darshanpvt007-afk/visionguard-smart-cane/docs/VisionGuard_Presentation.pptx

## VisionGuard

COURSE PROJECT

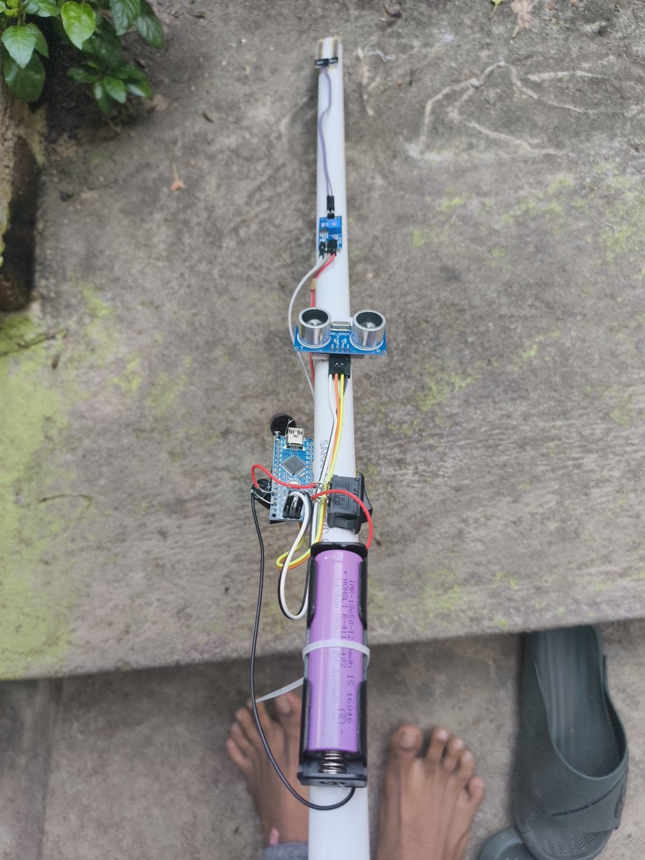
[picture p7: figure]

Smart cane for visually impaired people: obstacle and wet-surface warning with an Arduino Nano

S Darshan (25BCE2883) · Tanay Agarwal (25BCE2475)
BACSE324 Embedded Systems Architecture | B.Tech CSE, VIT Vellore

Notes: SPEAKER: BOTH (~25 s)

ACTION: Stand on either side of the screen. Darshan holds the cane.

DARSHAN: Good morning, sir. I'm S Darshan, registration number 25BCE2883.

TANAY: And I'm Tanay Agarwal, 25BCE2475.

DARSHAN: Our project is VisionGuard, a smart cane for visually impaired people. It warns the user about obstacles in front of them and about water at the tip of the cane.

## What this presentation covers

Problem

Why a normal cane is not enough

Objectives

What the cane must achieve

System design

Block diagram, hardware, circuit

01

02

03

Software

Algorithm, DFG, state diagram, code

Results

Prototype, tests and cost

Way forward

Limitations and future scope

04

05

06

Notes: SPEAKER: DARSHAN (~20 s)

DARSHAN: First I'll explain the problem, our objectives, the system design and the sensors. Then Tanay will cover the power, circuit, software, results, cost and future scope.

## The problem with a white cane

2.2 billion

people worldwide live with a near or distance vision impairment

Source: WHO, World Report on Vision, 2019

Contact-only detection

Obstacles are found only when the cane hits them, about 1 m ahead

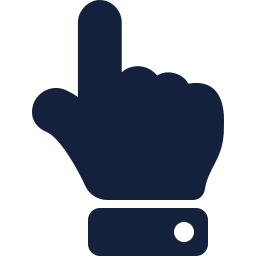
[picture p8: figure]
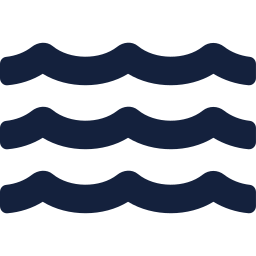
[picture p9: figure]

No water warning

Puddles, open drains and wet mud go unnoticed until stepped in

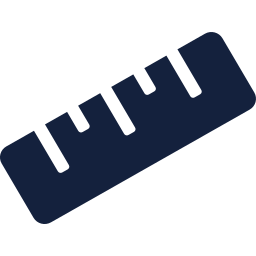
[picture p10: figure]

No distance information

The user cannot tell how close an obstacle is

Notes: SPEAKER: DARSHAN (~40 s)

ACTION: Point at the 2.2 billion figure, then the three points.

DARSHAN: According to the WHO, about 2.2 billion people around the world have some kind of vision impairment. Most blind people use a white cane, but it has three problems. First, it finds an obstacle only when it actually hits it. Second, it can't warn about water, puddles or open drains. Third, it doesn't tell the user how far away the obstacle is.

## Existing solutions and their limits

White cane

+ Cheap and simple

− Contact-only, no water or distance warning

Guide dog

+ Excellent navigation

− Expensive, long training, not widely available

Commercial canes

+ Electronic early warning

− High cost, imported, hard to repair locally

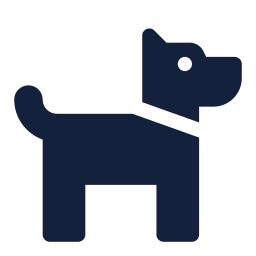
[picture p11: figure]
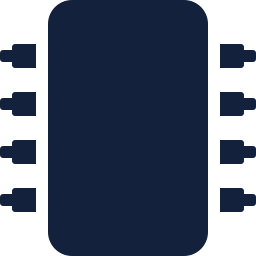
[picture p12: figure]

The gap: a low-cost cane that warns early about obstacles and about water underfoot

Notes: SPEAKER: DARSHAN (~35 s)

ACTION: Move left to right across the three boxes.

DARSHAN: We looked at what already exists. A white cane is cheap and simple, but it works only on contact. A guide dog is very helpful, but it's expensive, needs long training and isn't easily available. There are commercial smart canes, but they're costly, mostly imported and hard to repair here. So the gap we saw is a low-cost cane that warns early about both obstacles and water.

## Objectives

50 cm

Detect obstacles ahead with an ultrasonic sensor and warn before contact

50–400 ms

Encode distance in the beep gap: closer obstacle, faster beeps

< 500

ADC reading below this means water: continuous tone, top priority

₹876

Low-cost, portable cane running on one 18650 cell with a switch

Notes: SPEAKER: DARSHAN (~40 s)

ACTION: Point at each number as you say it.

DARSHAN: We set four objectives. One: detect obstacles within 50 centimetres. Two: show the distance through the beep speed. The gap between beeps goes from 50 milliseconds when the obstacle is very close to 400 milliseconds at 50 centimetres. Three: detect water when the moisture reading drops below 500 out of 1023, and give that the highest priority. Four: keep it cheap and portable. The cane parts cost about 876 rupees, and it runs on one battery.

## Proposed solution: VisionGuard

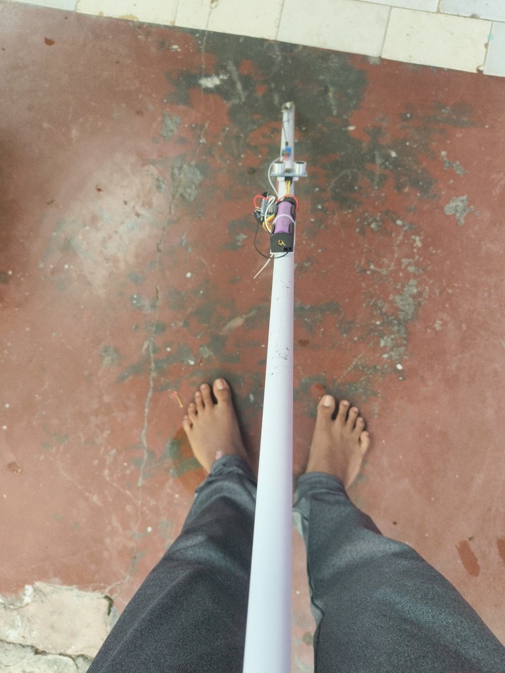
[picture p13: figure]

Ultrasonic “eyes”

HC-SR04 measures distance to obstacles ahead

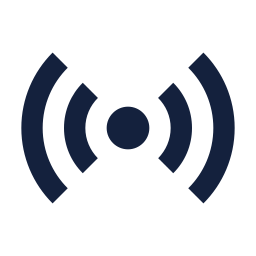
[picture p14: figure]
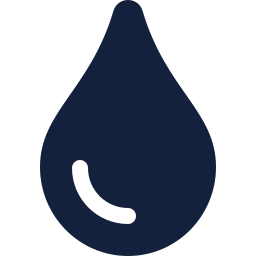
[picture p15: figure]

Moisture-sensing tip

Probe at the bottom detects water and wet mud

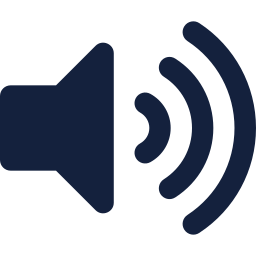
[picture p16: figure]

Prioritised buzzer alerts

Continuous tone for water; faster beeps as obstacles get closer

Notes: SPEAKER: DARSHAN (~35 s)

ACTION: Hold up the cane next to the photo.

DARSHAN: Our solution has three main parts on a PVC pipe: an ultrasonic sensor that works like the cane's eyes, a moisture probe at the tip, and a buzzer that gives alerts by priority. The idea actually started as a smart shoe. We moved it to a cane because the cane tip reaches water before the foot does, and a sensor on the shaft stays steadier than one on a moving shoe.

## Block diagram

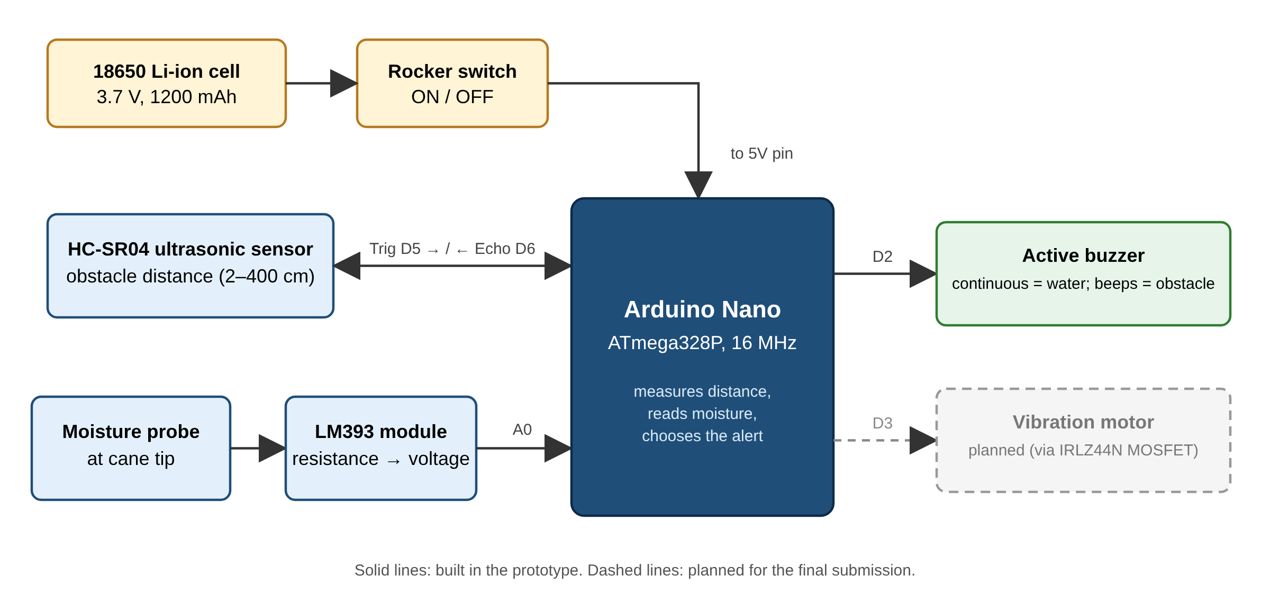
[picture p17: figure]

Notes: SPEAKER: DARSHAN (~40 s)

ACTION: Trace the diagram left, middle, right, then top.

DARSHAN: This is our block diagram. On the left are the inputs: the ultrasonic sensor connected to pins D5 and D6, and the moisture probe connected through the LM393 module to pin A0. In the middle is the Arduino Nano, which makes all the decisions. On the right is the output, the buzzer on pin D2. At the top, the battery powers everything through the on/off switch. The dashed box is a vibration motor, which we plan to add later.

## Hardware components

Arduino Nano

ATmega328P controller

HC-SR04

Ultrasonic distance sensor

Moisture probe

Water sensing at the tip

LM393 module

Probe resistance → voltage

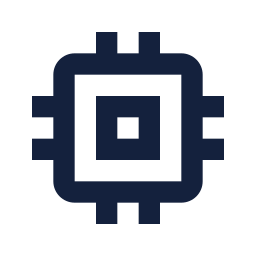
[picture p18: figure]
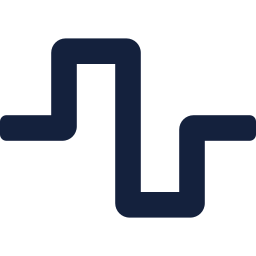
[picture p19: figure]

Active buzzer

Audio alert on D2

18650 Li-ion

3.7 V, 1200 mAh

Rocker switch

Power ON / OFF

Capacitor

220 µF, 50 V supply filter

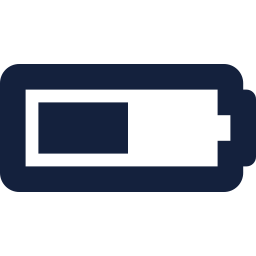
[picture p20: figure]
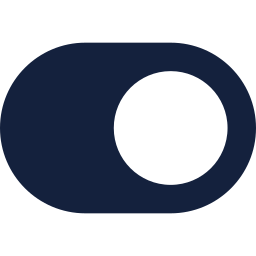
[picture p21: figure]
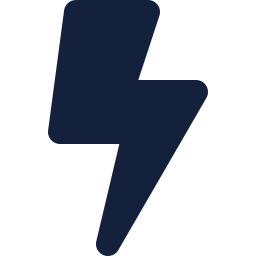
[picture p22: figure]

Notes: SPEAKER: DARSHAN (~35 s)

ACTION: Go across the top row, then the bottom row.

DARSHAN: These are the eight parts we used. The Arduino Nano is the controller. The HC-SR04 measures distance. The moisture probe and the LM393 module detect water. The active buzzer gives the alerts. The 18650 battery, the rocker switch and a 220 microfarad capacitor make up the power side. The capacitor smooths the supply so the Nano doesn't reset when the buzzer switches on.

## Why the Arduino Nano

16 MHz

ATmega328P clock

32 KB

Flash memory

- Small and light enough to mount on the cane shaft
- Low cost (about ₹250) and easy to replace
- 5 V logic matches the HC-SR04 and the moisture module
- Built-in ADC reads the moisture voltage directly
- Programmed over USB with the free Arduino IDE

10-bit

ADC, 8 analog inputs

18×45 mm

Fits on a cane

Notes: SPEAKER: DARSHAN (~30 s)

DARSHAN: We chose the Arduino Nano because it's small, only 18 by 45 millimetres, so it fits on a cane. It costs about 250 rupees. It uses 5-volt logic like our sensors, and it has a built-in 10-bit ADC to read the moisture sensor. It's also easy to program over USB. A Raspberry Pi would be too expensive and power-hungry for a simple job like this.

## How the ultrasonic sensor measures distance

1

Trigger

Nano holds Trig HIGH for 10 µs

d = v × t / 2

v ≈ 343 m/s = 0.034 cm/µs
÷ 2 because sound travels there and back
Example: t = 1000 µs → d = 0.034 × 1000 / 2 = 17 cm
Range 2–400 cm · beam ≈ 15°

2

Burst

Sensor sends eight 40 kHz sound pulses

3

Echo

Echo stays HIGH for the round-trip time t

Notes: SPEAKER: DARSHAN (~45 s)

ACTION: Point at steps 1, 2, 3, then the formula box.

DARSHAN: This is how the ultrasonic sensor works. Step one: the Nano sends a 10-microsecond pulse to the Trig pin. Step two: the sensor sends out eight sound pulses at 40 kilohertz, which is too high for us to hear. Step three: the Echo pin stays HIGH until the echo comes back. So distance equals speed of sound times time, divided by two. We divide by two because the sound goes to the object and comes back. The speed of sound is about 0.034 centimetres per microsecond, so if the echo takes 1000 microseconds, the distance is 17 centimetres.

## How the tip detects water

Water conducts electricity, so the resistance Rp between the copper tracks drops. The LM393 module turns this into a voltage:

V_A0 = Vcc × Rp / (Rp + Rf)

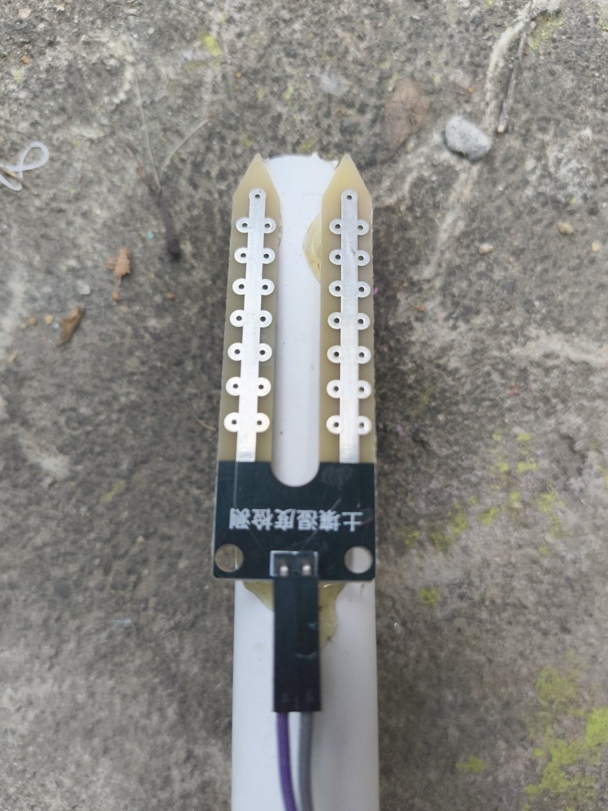
[picture p23: figure]

Moisture probe at the cane tip: two exposed copper tracks

≈ 1023

Dry: Rp very high

< 500

Wet: water alert

The reading is ratiometric (independent of battery voltage). The D0 output is unused; the threshold is set in code.

Notes: SPEAKER: DARSHAN (~45 s)

ACTION: Point at the probe on the real cane. End by turning towards Tanay.

DARSHAN: This is the moisture probe at the tip. It has two copper strips. Dry air doesn't conduct electricity, but water does, so when the tip touches water, the resistance between the strips drops. The LM393 module turns this into a voltage, and the Nano reads it on A0. When it's dry the reading is about 1023, and when it's wet it goes below 500. We use the analog output instead of the digital D0 pin, so we can set the threshold in the code.

DARSHAN: Now Tanay will explain the power system and the circuit.

## Power system

18650 cell

3.7 V, 1200 mAh

Rocker switch

ON / OFF

5V pin

Nano + both sensors

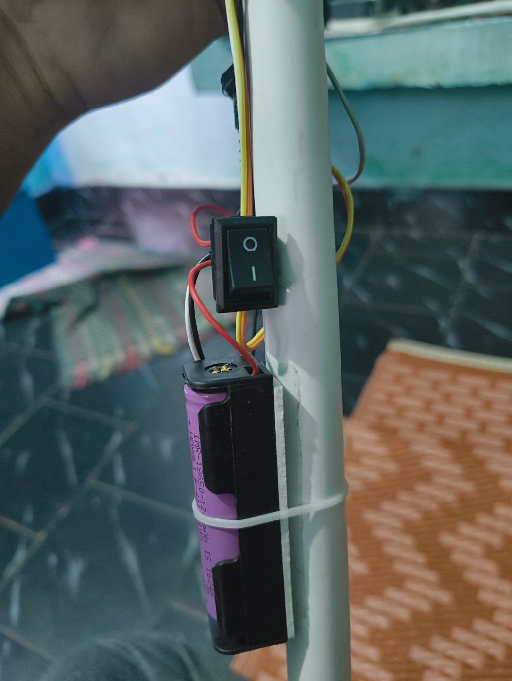
[picture p24: figure]

~40 mA

total current draw

≈ 30 h

theoretical runtime

Safety: switch OFF before plugging in USB. The battery feeds the 5V rail directly.

Notes: SPEAKER: TANAY (~35 s)

ACTION: Point at battery → switch → 5V pin, then the warning.

TANAY: Thank you. The cane runs on one 18650 lithium-ion battery: 3.7 volts, 1200 milliamp-hours. It goes through the rocker switch to the Nano's 5V pin, which also powers both sensors. We didn't use the VIN pin, because VIN needs about 7 volts. The whole cane draws around 40 milliamps, so in theory the battery can last about 30 hours. One safety point: we always switch the cane off before connecting USB, because the battery is connected directly to the 5V line.

## Circuit diagram


- Shared +5 V and GND rails
- Trig → D5, Echo → D6
- Moisture A0 → A0
- Buzzer → D2
- 220 µF capacitor across 5V and GND
- D3 reserved for a vibration motor

Notes: SPEAKER: TANAY (~40 s)

ACTION: Point at the red 5V line and black GND line first.

TANAY: This is the full circuit. The red line is 5 volts and the black line is ground. Every module shares them. Trig goes to D5, Echo to D6, the moisture signal to A0 and the buzzer to D2. In the final cane we didn't use a breadboard. We soldered male header pins onto the Nano, and since the sensors also have header pins, the signal wires are female jumper wires plugged onto both ends. The power wires, the buzzer and the 220 microfarad capacitor are soldered for a strong connection.

## Pin connections

Device pin | Nano pin | Purpose
Battery + (via switch) | 5V | Power, 3.0–4.2 V
Battery − | GND | Common ground
HC-SR04 Trig | D5 | 10 µs trigger pulse (output)
HC-SR04 Echo | D6 | Echo pulse width (input)
LM393 A0 | A0 | Moisture value 0–1023
LM393 D0 | — | Not used
Buzzer + | D2 | HIGH = sound
Sensor VCC / GND | 5V / GND | Module power

Notes: SPEAKER: TANAY (~20 s)

TANAY: This table lists every connection. The main pins to remember are D5 for Trig, D6 for Echo, A0 for moisture and D2 for the buzzer. The LM393's D0 pin isn't used.

## Algorithm

Initialise

Set pin modes, start Serial at 9600

Measure distance

Trigger, pulseIn() with 30 ms timeout, d = t × 0.034 / 2

Read moisture

m = analogRead(A0), 0–1023

1

2

3

Water?

If m < 500, buzzer ON continuously

Obstacle?

Else if 0 < d < 50, beep 50 ms, wait map(d) = 50–400 ms

Clear

Else buzzer OFF; wait 30 ms and repeat

4

5

6

Notes: SPEAKER: TANAY (~45 s)

ACTION: Point at boxes 1 to 6 in order.

TANAY: This is our algorithm. First the Nano sets up the pins. Then, in a loop, it measures the distance and reads the moisture. Then it decides. If the moisture is below 500, that's water, so the buzzer stays on continuously. If not, and an obstacle is closer than 50 centimetres, it beeps for 50 milliseconds and then waits a gap between 50 and 400 milliseconds depending on the distance. Otherwise the path is clear and the buzzer stays off. Then it waits 30 milliseconds and repeats.

## Data flow graph


Echo time t becomes distance d, which feeds two branches (near, and beep gap g); moisture m becomes wet. The priority select drives the buzzer.

Notes: SPEAKER: TANAY (~35 s)

ACTION: Trace the top path, then the bottom path, then the priority box.

TANAY: The data flow graph shows how the data is processed. The echo time t is multiplied by 0.034 and divided by 2 to get the distance d. The distance is used in two places: to check whether the obstacle is near, and to work out the beep gap g. The moisture value m is compared with 500 to decide whether it's wet. Finally, the priority block uses wet, near and g to control the buzzer.

## State diagram


Every loop the system senses, then enters exactly one state: WATER, OBSTACLE or CLEAR. Water always wins.

Notes: SPEAKER: TANAY (~30 s)

ACTION: Follow the arrows from OFF to SENSE, then the three states.

TANAY: This is the state diagram. When the switch is turned on, the cane sets up once and goes to SENSE. From SENSE it goes into exactly one state: water alert, obstacle alert or clear. After 30 milliseconds it comes back to SENSE. Turning the switch off takes it back to OFF from any state.

## Key code logic

int readDistanceCm() {
digitalWrite(TRIG_PIN, HIGH);
delayMicroseconds(10);
digitalWrite(TRIG_PIN, LOW);
unsigned long t =
pulseIn(ECHO_PIN, HIGH, 30000);
return t * 0.034 / 2;
}
if (soil < 500) // water
buzzer ON (continuous);
else if (d > 0 && d < 50)
beep, gap = map(d,2,50,50,400);
else buzzer OFF; // clear

pulseIn() timeout

30 ms, so a missed echo cannot freeze the loop

0.034 / 2

Speed of sound in cm/µs, halved for the round trip

map()

Turns 2–50 cm into a 50–400 ms beep gap

Notes: SPEAKER: TANAY (~40 s)

ACTION: Point at the top half of the code, then the bottom half. End by turning towards Darshan.

TANAY: This is the main part of our code. The readDistanceCm function sends the trigger pulse and uses pulseIn with a 30-millisecond timeout. Without the timeout, it would wait up to one second when there's no echo and freeze the cane. Below that is the if-else chain. Water is checked first, so it always has priority. The map function converts the distance into the beep gap.

TANAY: Now Darshan will show you the prototype.

## Prototype and assembly

Complete cane, tip at the top

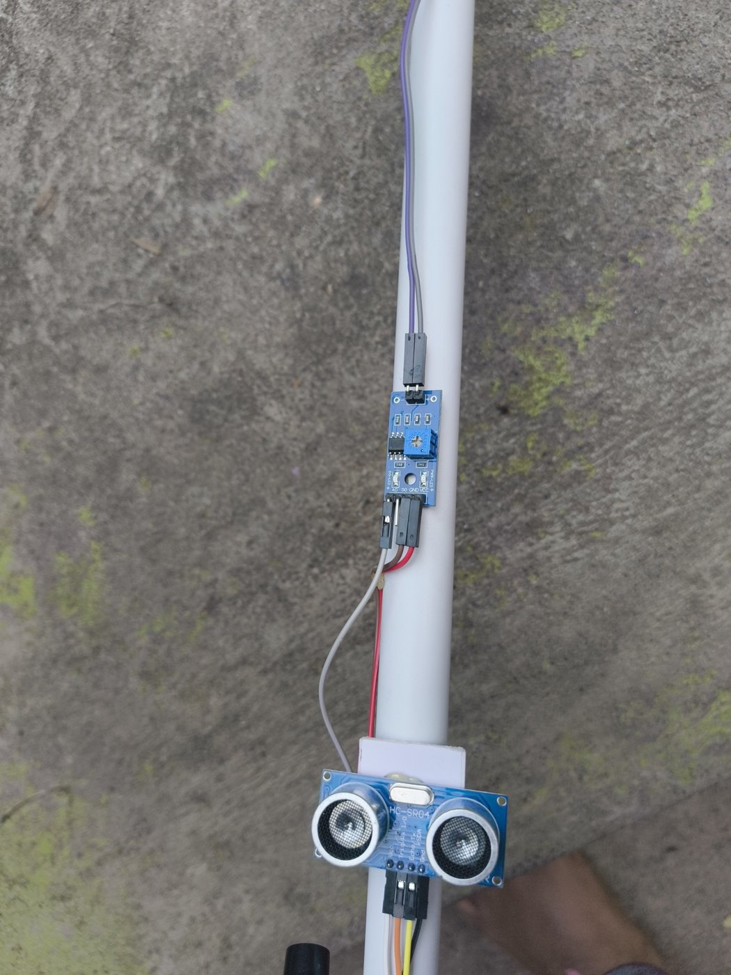
[picture p25: figure]

LM393 and HC-SR04 on female jumpers

- Male header pins soldered onto the Nano
- Sensors joined with female jumper wires: Trig D5, Echo D6, moisture A0
- Power wires, buzzer and 220 µF capacitor soldered
- Parts hot-glued to the PVC pipe; HC-SR04 on a foam spacer; battery cable-tied
- No breadboard in the final build

Notes: SPEAKER: DARSHAN (~75 s)

ACTION: Point at the photos, then at the real cane. DEMO: switch on → hand from far to near → dip tip in water.

DARSHAN: This is our prototype and how we put it together. We soldered male header pins onto the Nano and connected the sensors with female jumper wires: Trig to D5, Echo to D6 and the moisture output to A0. The power wires, the buzzer and the capacitor are soldered. All the parts are hot-glued to the PVC pipe, the ultrasonic sensor sits on a foam spacer, and the battery holder is cable-tied. From the bottom: the probe, the LM393 module, the ultrasonic sensor, the Nano with the buzzer, then the switch and battery near the handle.

DARSHAN: Let me show you. I'm switching it on. It's silent now because the path is clear. Now I'll move my hand closer. It starts beeping at 50 centimetres and gets faster as I get closer. Now I'll dip the tip in water. It gives a continuous beep, which means water is detected.

DARSHAN: Tanay will now show our test results.

## Testing and results

Test | Method | Expected | Result
Power on battery | Switch ON, no USB | Nano LED on, system runs | Verified
Obstacle alert | Move a notebook from 60 to 5 cm | Beeps under 50 cm, faster when closer | Verified
Path clear | Point at open space | Silent | To confirm
Water alert | Dip probe tip in water | Continuous tone | Calibrating
Priority | Water + obstacle together | Continuous tone (water wins) | To confirm

Update the Result column after the Serial Monitor tests (dry and wet readings).

Notes: SPEAKER: TANAY (~30 s)

ACTION: Point at the Result column.

TANAY: These are our tests. Running on battery and the obstacle alert are both verified. The water alert is in the code, and we're calibrating the exact threshold using the dry and wet readings on the Serial Monitor. We'll update this table once that's done.

## Cost of the cane hardware

₹876

total cane hardware

₹1,805 including tools (₹660) and parts for planned upgrades (₹269). Prices from the supplier invoice; buzzer and PVC body estimated.

Notes: SPEAKER: TANAY (~25 s)

ACTION: Point at ₹876.

TANAY: The parts on the cane cost about 876 rupees. Our total spending was 1,805 rupees, but that includes tools like the soldering iron and extra parts for the next version, like the MOSFET and the fuse. That's much cheaper than commercial smart canes.

## Advantages and limitations

Advantages

- Warns before contact; distance shown by beep rate
- Detects water and wet mud, unlike most basic smart canes
- Low cost, local parts, easy to repair
- Rechargeable battery, simple on/off use

Limitations

- Narrow ~15° beam misses head-level and thin obstacles
- Water detected only when the tip touches it
- Resistive probe corrodes over time
- Unregulated 3.7 V supply, no low-battery warning
- Buzzer hard to hear in heavy traffic

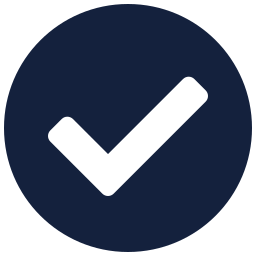
[picture p26: figure]
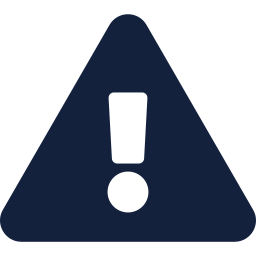
[picture p27: figure]

Notes: SPEAKER: TANAY (~35 s)

ACTION: Left box first, then right box.

TANAY: The advantages: it warns before the user hits an obstacle, it shows the distance through the beep speed, it detects water, and it's cheap and easy to repair. The limitations, to be honest: the sensor's beam is narrow, so it can miss head-level objects. Water is detected only when the tip touches it. The probe will corrode over time. The battery isn't regulated. And the buzzer can be hard to hear in traffic.

## Future scope

Vibration motor

Silent haptic alerts via the IRLZ44N MOSFET

Regulated power

5 V boost converter, TP4056 charger, 1 A fuse

More sensors

Angled up for heads, down for steps and potholes

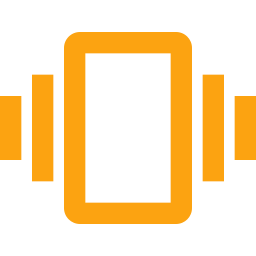
[picture p28: figure]
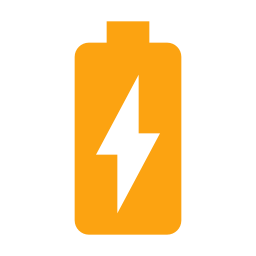
[picture p29: figure]
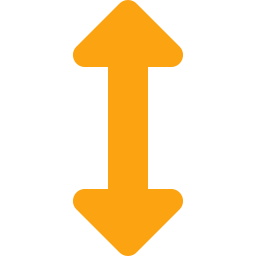
[picture p30: figure]

Capacitive probe

No exposed metal, so no corrosion

GPS + SOS

Send location to family via GSM or Bluetooth

PCB + enclosure

Waterproof, robust, ready for field trials

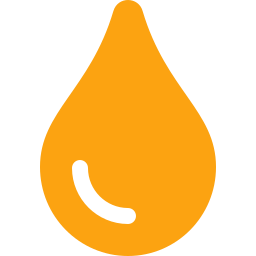
[picture p31: figure]
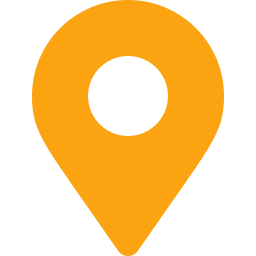
[picture p32: figure]
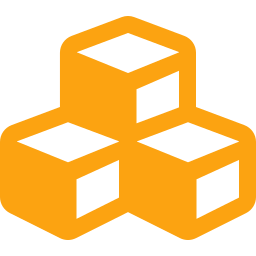
[picture p33: figure]

Notes: SPEAKER: TANAY (~30 s)

TANAY: To fix these, we plan to add a vibration motor using the MOSFET, so the user can feel the alerts. We also plan proper power with a boost converter, a charger and a fuse; extra sensors pointing up and down for head-level objects and steps; a capacitive moisture sensor that won't corrode; GPS with an SOS message; and finally a PCB inside a waterproof box.

## References

[1] Elecfreaks, “Ultrasonic Ranging Module HC-SR04,” datasheet, 2011.
[2] Microchip Technology, “ATmega328P megaAVR Data Sheet,” DS40002061, 2020.
[3] Arduino, “Arduino Nano,” docs.arduino.cc/hardware/nano
[4] Arduino, “Language Reference: pulseIn(), analogRead(), map(),” arduino.cc/reference
[5] Texas Instruments, “LM393 Dual Comparator,” datasheet, ti.com/product/LM393
[6] World Health Organization, “World Report on Vision,” Geneva, 2019.

Notes: SPEAKER: TANAY (~10 s)

TANAY: These are the datasheets and documents we referred to.

## Thank you

Conclusion

- A plain cane becomes a low-cost electronic travel aid
- Warns about obstacles before contact, with distance in the beep rate
- Gives priority warnings for water underfoot
- Runs from one rechargeable cell for about ₹876

Questions?

Notes: SPEAKER: BOTH (~25 s)

ACTION: Both face the faculty.

DARSHAN: To conclude, VisionGuard turns a normal cane into a low-cost electronic aid. It warns about obstacles early, shows the distance through the beep speed, and gives a priority warning for water, all for under 900 rupees.

TANAY: Thank you, sir. We're happy to answer any questions.
