darshanpvt007-afk/visionguard-smart-cane/(commit log)

2026-10-23 Add firmware, project report and Review 1 prep docs
    Keep the original sketch unchanged; add a provisional sketch with a
    pulseIn timeout, clamped beep mapping and state output on Serial.
    Claude-Session: https://claude.ai/code/session_01RBCZvHRngDWn2z2Egxvtcp
2026-10-23 Record battery wiring (switch to 5V pin) and its limits in docs
    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
2026-10-23 Add filled Review 1 submission and block/circuit diagrams
    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
2026-10-26 Fill slot, faculty and submission date; refresh zip
    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
2026-10-26 Update zip README with slot, faculty and date
    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
2026-10-27 Presentation: new photos, 220 uF capacitor, correct header-pin wiring, assembly slide
    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
2026-10-27 Presentation: use clean prototype photos; add photos folder to zip
    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
2026-10-27 Update all documents: clean photos, 220 uF capacitor, header-pin wiring, circuit label
    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
2026-10-27 Add deep viva questions sheet (architecture, ADC, timing, power)
    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
2026-10-27 Add from-scratch build guide with deep questions per stage
    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
2026-10-29 Firmware: match the cane's actual wiring (Trig A0, Echo A1, moisture A2, buzzer D13)
    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
    [visionguard.ino]
2026-10-29 Firmware: self-test, low-battery warning, heartbeat, median filter, non-blocking alerts
    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
2026-10-29 Add crisp viva script (levels 1-6 and A-Z terms) for the actual wiring
    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
